BluQRP/DX_UnO/DX UnO PCB Layout.jpg

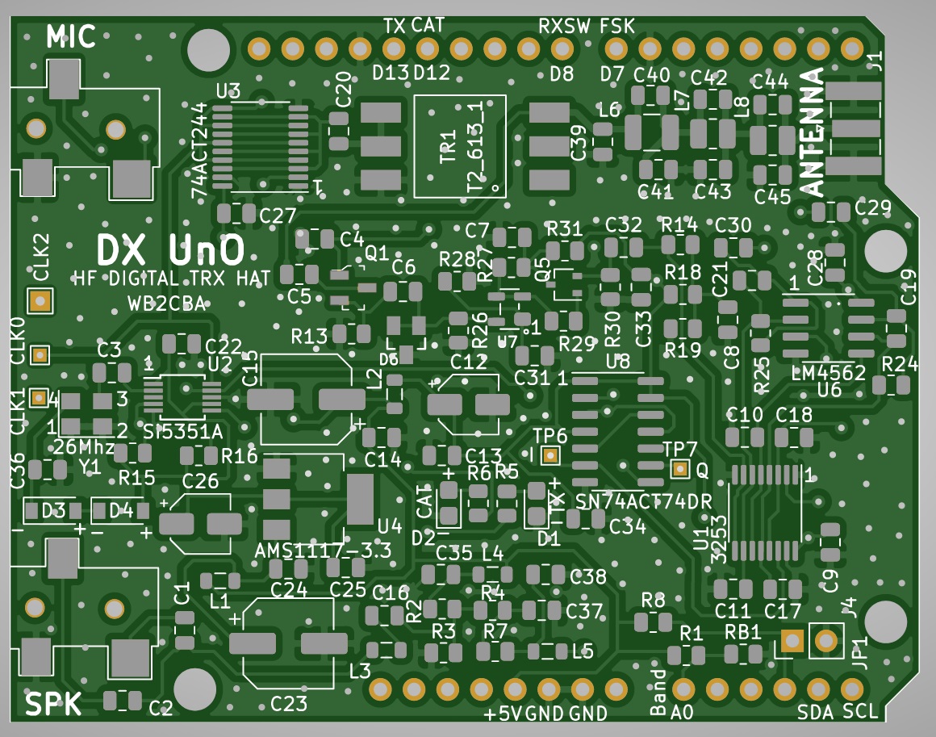
DX UnO PCB Layout.jpg
