BluQRP/DX_UnO/DX UnO Standalone WSPR Transmitter conversion/DX UnO STANDALONE MULTIBAND WSPR TRANSMITTER CONVERSION MANUAL.pdf

HOW TO CONVERT DX UnO TRANSCEIVER INTO 5 BAND STANDALONE WSPR TRANSCEIVER

By only adding a GPS MODULE and replacing firmware of DX UnO with Standalone WSPR firmware we can convert DX UnO to a Stand Alone WSPR transceiver that can transmit on 20m,17m,15m,12m and 10m Bands WSPR frequency back-to-back in 2 minutes intervals.

For this modificaon we need to do:
1- HARDWARE MODIFICATION
2- FIRMWARE MODIFICATION

1- HARDWARE MODIFICATION:

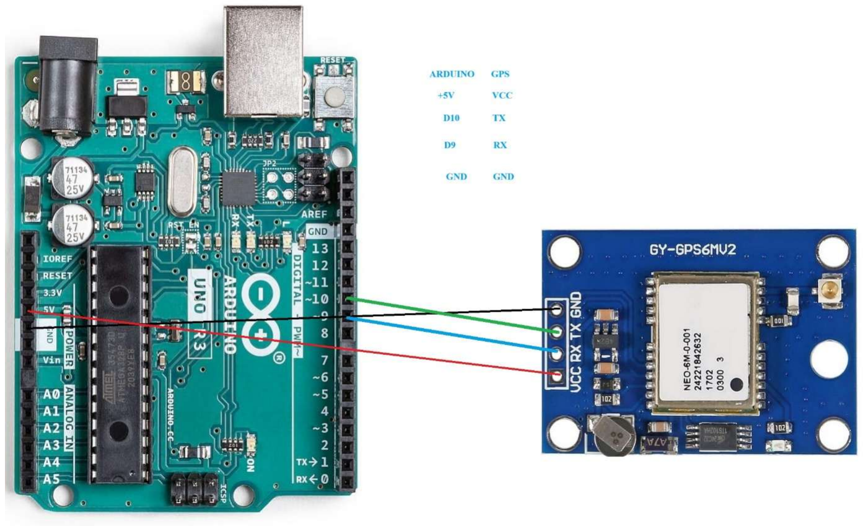
[picture p24: figure]

For HARDWARE MODIFICATION a GPS Module need to be added. This GPS MODULE helps in two points. Geng the maiden grid locaon and Time synchronizaon.
Any GPS MODULE will work as long as it’s a +5V module and we know the baud rate of GPS UART.

For adding GPS Module there needs to be 4 main connecons between GPS Module and Arduino Uno. These are:
1- GPS GND to ARDUINO UNO GND
2- GPS VCC to ARDUINO UNO +5V
3- GPS TX to Arduino Uno D10 Pin 4- GPS RX to Arduino Uno D9 Pin

2- FIRMWARE MODIFICATION:
To achieve standalone DX UnO WSPR TRANSCEIVER, we need to replace DX UnO Firmware with Standalone WSPR firmware.

DX UnO Standalone WSPR firmware is modified WSPR Mulband firmware by Roel Kroes, hps://github.com/RoelKroes/wsprbeacon

I modified slightly this Arduino sketch to work with DX UnO.

1- Download:
DX_UnO_WSPR_MULTIBAND_V1.0.ino,
GPS.ino
Messages.ino
Sengs.h

files from DX UnO github page and save all in the same directory

2- Modify sengs.h aer opening all files on Arduino IDE like in below photos:
- Enter Your Callsign
- Enable Debug mode if you wish to monitor what is Standalone WSPR doing with Serial monitor. If not needed just comment it.

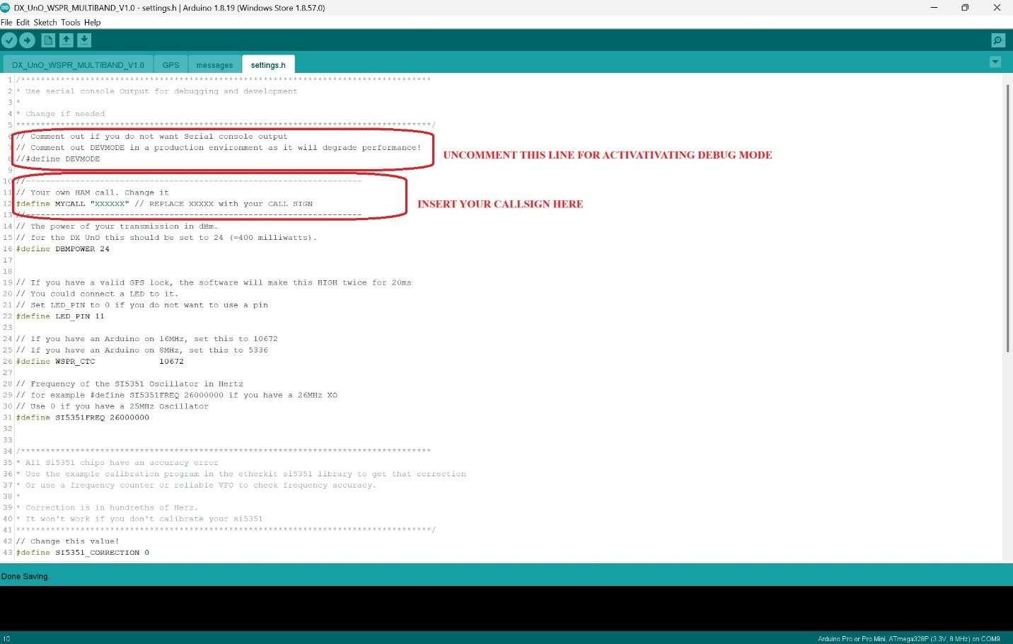
[picture p25: figure]

Modify GPS Baud Rate inline with your GPS baud rate.

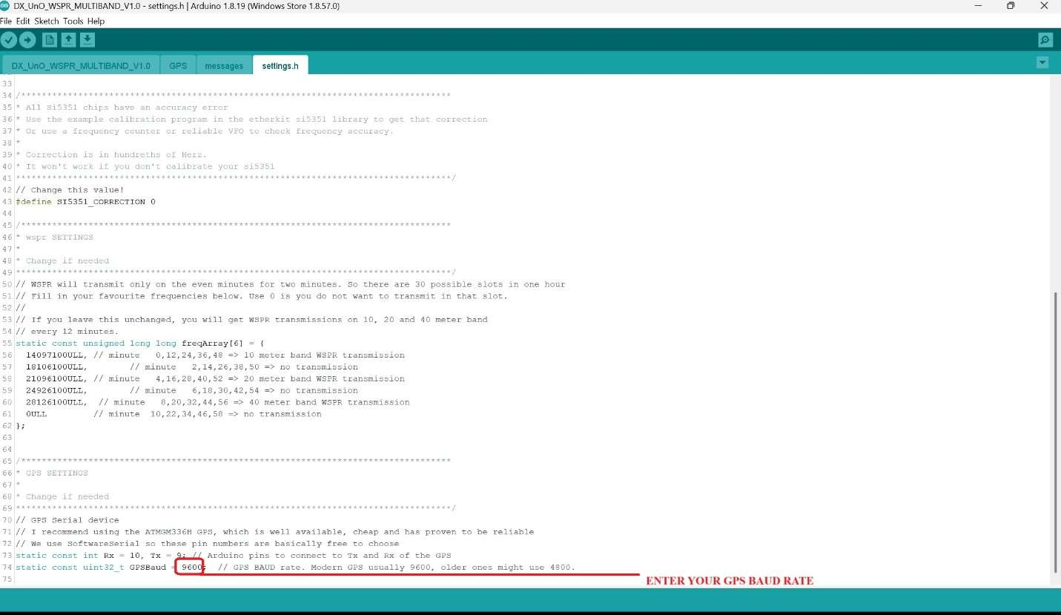
[picture p26: figure]

Now upload your modified and saved DX UnO standalone WSPR firmware to your DX UnO as you upload to any Arduino Uno via Arduino IDE.
That’s all needed to run DX Uno Standalone WSPR.

When you first power on DX UnO WSPR nothing will happen unl GPS receives data.
When GPS starts geng GPS data Blue CAT led blinks intermiently. This means GPS data is received and valid.

When TX mes comes Blue LED will be off and Red TX led will be on for2 minutes.
At the end of TX, Red LED will be off and Blue LED will blink intermient.
This loop connues like that. In every TX sequence DX Uno WSPR will switch to a different band. This will give you a nice clue about your antenna efficiency in different bands.
When operang DX UnO with WSPR conversion MIC and SPK sockets will be redundant and not used so no need to connect these. The only cable connecon is USB cable which will be used only for powering up DX UnO WSPR. It can just be connected to a USB power source with +5V through Arduino Uno.
If you want this DX UnO WSPR conversion a bit neater and more elegant you can also use this PCB module which is a GPS Carrier board:

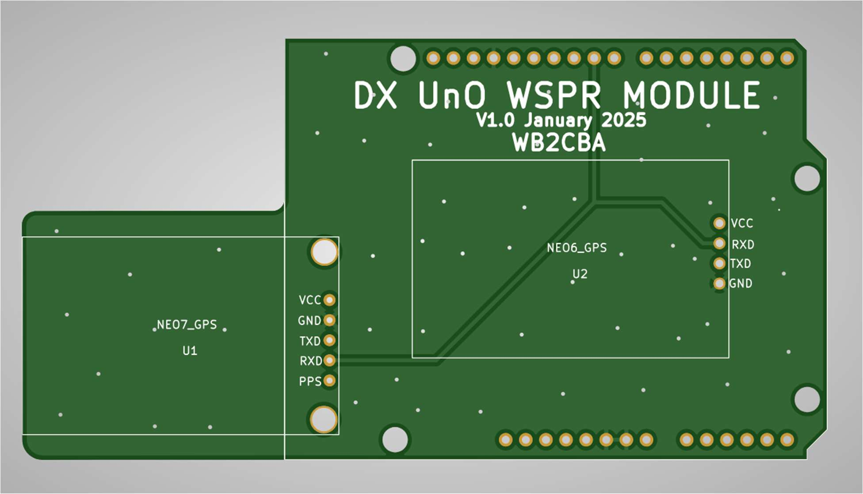
[picture p27: figure]

This has two GPS type you can solder on. This pcb stacks between Arduino Uno and DX UnO which creates a three pcb sandwich like rig. Use long pin Arduino Shield headers.
Gerber file of this GPS Carrier PCB is in DX UnO Github page: hps://github.com/BluQRP/DX_UnO

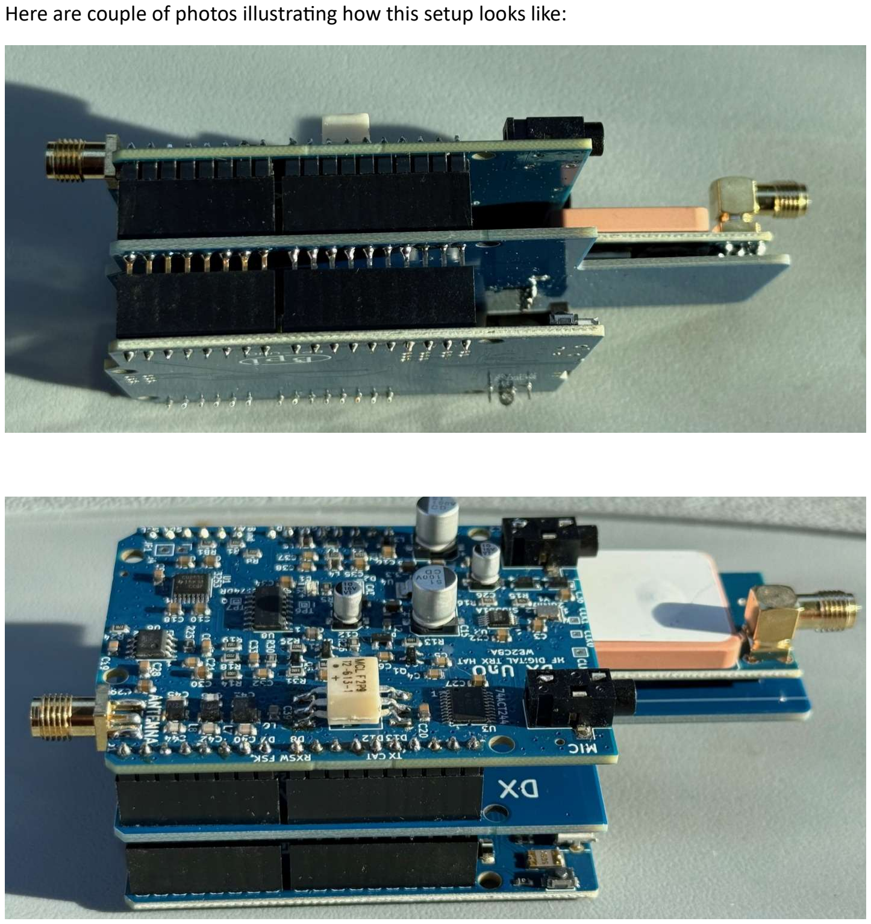
[picture p28: page 6]

Here are couple of photos illustrang how this setup looks like:

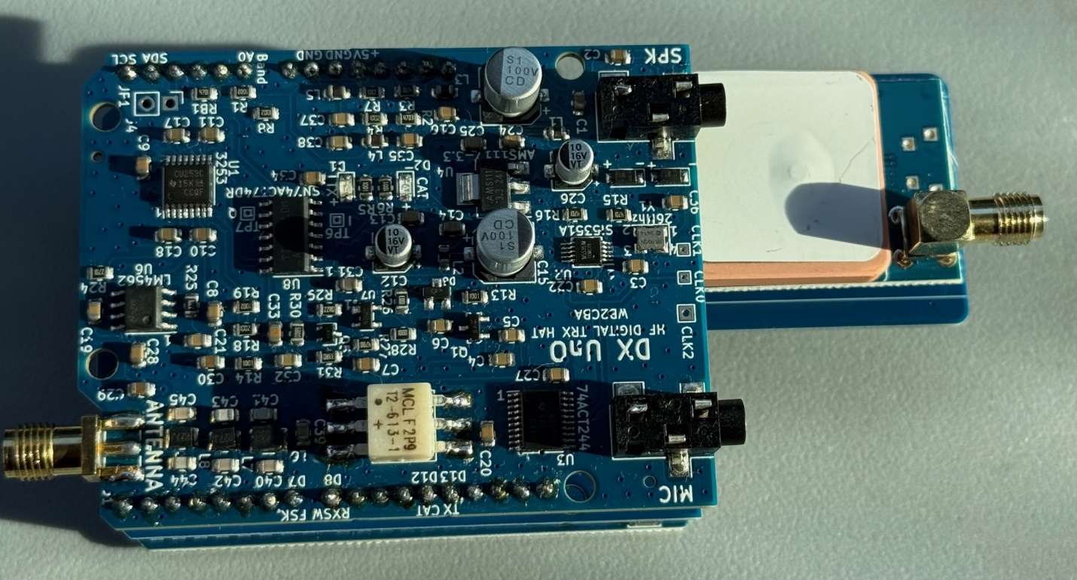
[picture p29: figure]
