BluQRP/DX_UnO/DX UnO High Bands Version Schematic.pdf

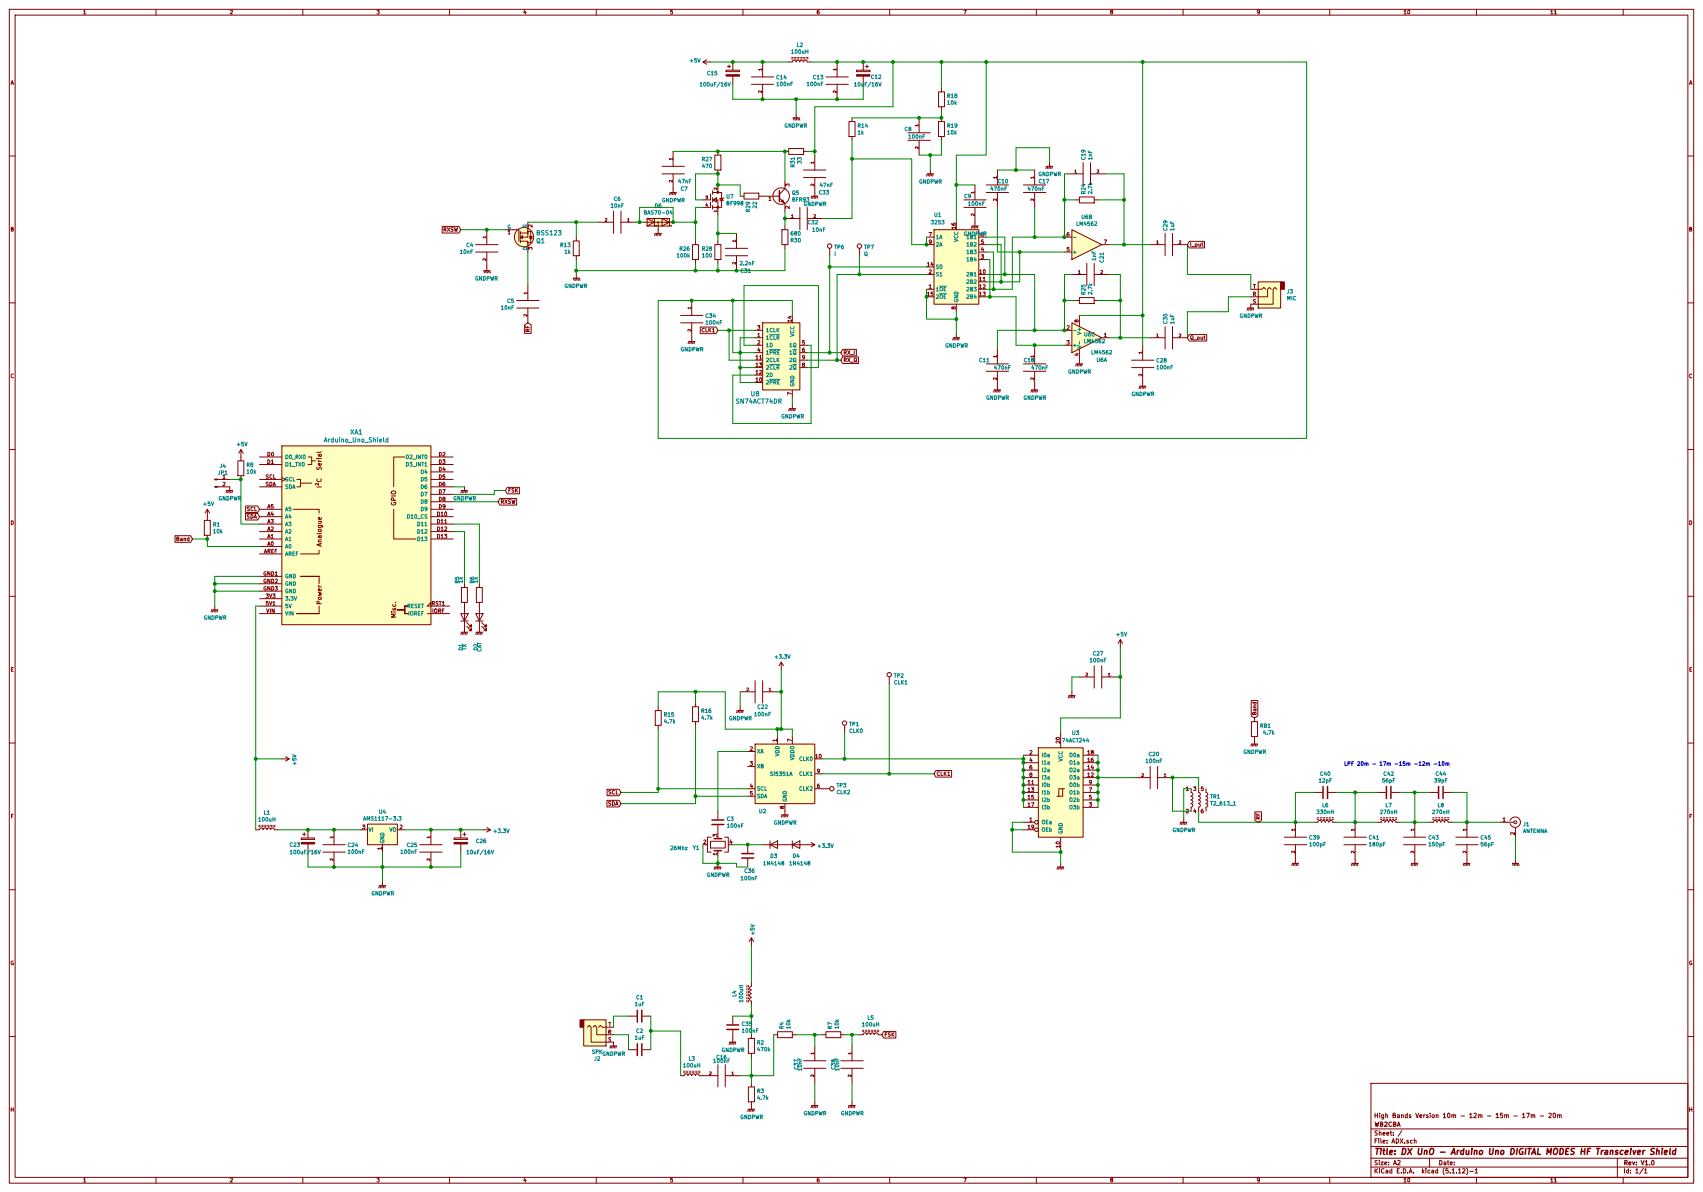
[picture p30: page 1]
